2tn/CREATE_Noshiro/基板/rogger.brd

## EAGLE design 基板/rogger.brd (2018-05-12)

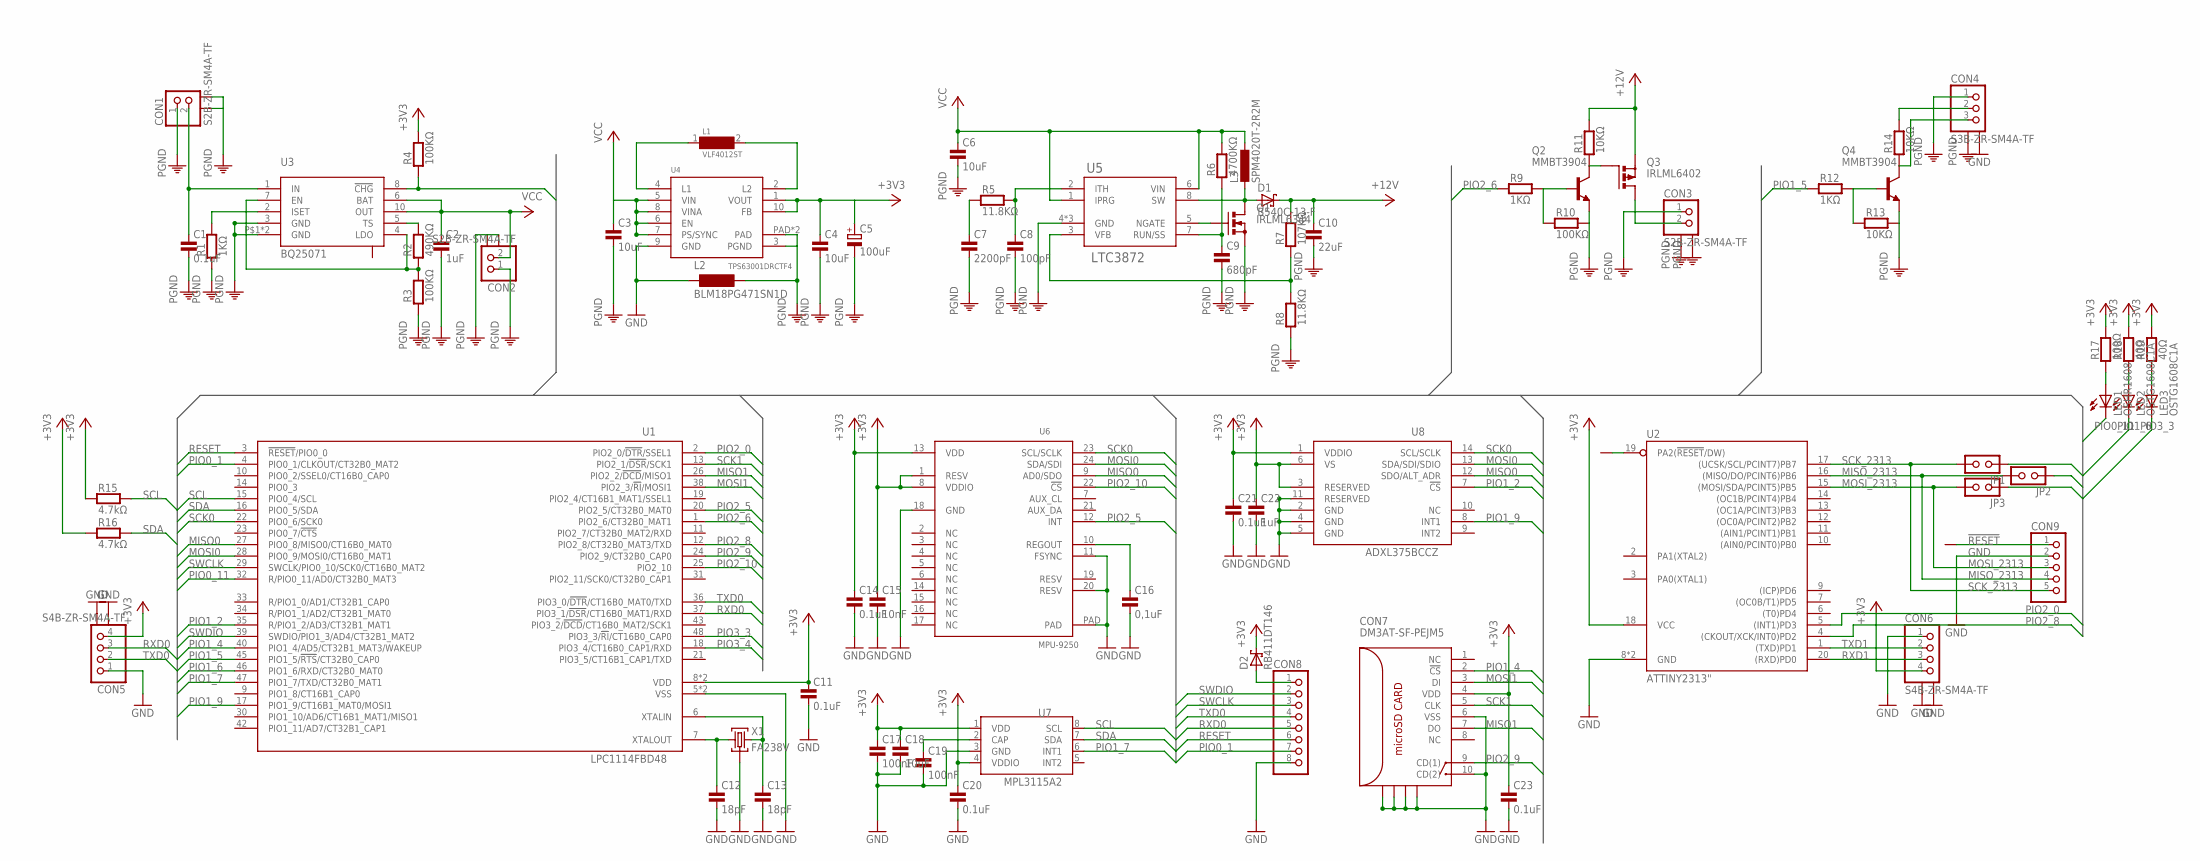
[picture p1: schematic rogger.sch]

Parts:
C1, C11, C14, C20, C21, C23: 0.1uF; 0603
C2, C22: 1uF; 0603
C3, C4, C6, C18: 10uF; 0603
C5: 100uF; 153CLV-0505
C7: 2200pF; 0603
C8: 100pF; 0603
C9: 680pF; 0603
C10: 22uF; 0805
C12, C13: 18pF; 0603
C15: 10nF; 0603
C16: 0,1uF; 0603
C17, C19: 100nF; 0603
CON1, CON2, CON3: S2B-ZR-SM4A-TF
CON4: S3B-ZR-SM4A-TF
CON5, CON6: S4B-ZR-SM4A-TF
CON7: DM3AT-SF-PEJM5
CON8: PINHEAD1X8; 1X8
CON9: PINHEAD1X5; 1X5
D1: B540C-13-F; SMC
D2: RB411DT146; SOT23
JP1, JP2, JP3: JUMP-2
L1: VLF4012ST
L2: BLM18PG471SN1D; 0603
L3: SPM4020T-2R2M
LED1: OSHR1608; CHIP-LED0603
LED2, LED3: OSTG1608C1A; CHIP-LED0603
Q1: IRLML6344; SOT23
Q2, Q4: MMBT3904; SOT23
Q3: IRLML6402; SOT23
R1, R9, R12: 1KΩ; 0603
R2: 490KΩ; 0603
R3, R4, R10: 100KΩ; 0603
R5, R8: 11.8KΩ; 0603
R6: 4700KΩ; 0603
R7: 107KΩ; 0603
R11, R13, R14: 10KΩ; 0603
R15, R16: 4.7kΩ; 0603
R17: 100Ω; 0603
R18, R19: 40Ω; 0603
U1: LPC1114FBD48; LQFP48
U2: ATTINY2313"; MLF20
U3: BQ25071; W-PWSON-N10
U4: TPS63001DRCTF4; S-PVSON-N10
U5: LTC3872; TSOT-23-8
U6: MPU-9250; 24QFN
U7: MPL3115A2
U8: ADXL375BCCZ; LGA-14
X1: FA238V; V66RA

Connections:
!RESET!: CON9.1, U2.19 (PA2(!RESET!/DW))
+3V3: C4.1, C5.+, C11.1, C14.1, C15.1, C17.1, C18.1, C20.1, C21.1, C22.1, C23.1, CON5.4, CON6.4, CON7.4 (VDD), D2.3 (C), R4.2, R15.1, R16.1, R17.2, R18.2, R19.2, U1.8 (VDD), U1.44 (VDD), U2.18 (VCC), U4.1 (VOUT), U4.10 (FB), U6.1 (RESV), U6.8 (VDDIO), U6.13 (VDD), U7.1 (VDD), U7.4 (VDDIO), U8.1 (VDDIO), U8.3 (RESERVED), U8.6 (VS)
+5V: CON4.2, R14.2
+12V: C10.1, D1.C, Q3.2 (S), R7.2, R11.2
GND: C11.2, C12.2, C13.2, C14.2, C15.2, C16.2, C17.2, C18.2, C19.2, C20.2, C21.2, C22.2, C23.2, CON4.PAD2, CON5.1, CON5.PAD1, CON5.PAD2, CON6.1, CON6.PAD1, CON6.PAD2, CON7.6 (VSS), CON7.10 (CD(2)), CON7.P$10, CON7.P$11, CON7.P$12, CON7.P$14, CON8.8, CON9.2, L2.1, U1.5 (VSS), U1.41 (VSS), U2.8 (GND), U2.P$1 (GND), U4.9 (GND), U6.11 (FSYNC), U6.18 (GND), U6.20 (RESV), U6.PAD, U7.3 (GND), U8.2 (GND), U8.4 (GND), U8.5 (GND), U8.11 (RESERVED), X1.P2GND (GND), X1.P4GND (GND)
MISO0: JP2.2, U1.27 (PIO0_8/MISO0/CT16B0_MAT0), U6.9 (AD0/SDO), U8.12 (SDO/ALT_ADR)
MISO1: CON7.7 (DO), U1.26 (PIO2_2/!DCD!/MISO1)
MISO_2313: CON9.4, JP2.1, U2.16 ((MISO/DO/PCINT6)PB6)
MOSI0: JP3.2, U1.28 (PIO0_9/MOSI0/CT16B0_MAT1), U6.24 (SDA/SDI), U8.13 (SDA/SDI/SDIO)
MOSI1: CON7.3 (DI), U1.38 (PIO2_3/!RI!/MOSI1)
MOSI_2313: CON9.3, JP3.1, U2.15 ((MOSI/SDA/PCINT5)PB5)
unnamed: C12.1, U1.7 (XTALOUT), X1.P1X1 (X1)
unnamed: C13.1, U1.6 (XTALIN), X1.P3X2 (X2)
unnamed: CON8.1, D2.1 (A)
unnamed: L1.1, U4.4 (L1)
unnamed: L1.2, U4.2 (L2)
unnamed: C19.1, U7.2 (CAP)
unnamed: Q1.1 (G), U5.5 (NGATE)
unnamed: D1.A, L3.P$2 (2), Q1.3 (D), U5.8 (SW)
unnamed: C16.1, U6.10 (REGOUT)
unnamed: C9.1, R6.1, U5.7 (RUN/SS)
unnamed: R1.2, U3.2 (ISET)
unnamed: R7.1, R8.2, U5.3 (VFB)
unnamed: R2.2, U3.5 (TS)
unnamed: R2.1, R3.2, U3.4 (LDO), U3.7 (EN)
unnamed: C8.1, R5.2, U5.2 (ITH)
unnamed: CON3.2, Q3.3 (D)
unnamed: C7.1, R5.1
unnamed: Q2.3 (C), Q3.1 (G), R11.1
unnamed: CON4.3, Q4.3 (C), R14.1
unnamed: Q2.1 (B), R9.2, R10.1
unnamed: Q4.1 (B), R12.2, R13.1
unnamed: LED1.A, R17.1
unnamed: C1.1, CON1.2, U3.1 (IN)
unnamed: LED2.A, R18.1
unnamed: LED3.A, R19.1
PAD: U3.9 (PAD)
PE: C1.2, C2.2, C3.2, C4.2, C5.-, C6.2, C7.2, C8.2, C9.2, C10.2, CON1.1, CON1.PAD1, CON1.PAD2, CON2.1, CON2.PAD1, CON2.PAD2, CON3.1, CON3.PAD1, CON3.PAD2, CON4.1, CON4.PAD1, L2.2, Q1.2 (S), Q2.2 (E), Q4.2 (E), R1.1, R3.1, R8.1, R10.2, R13.2, U3.3 (GND), U3.P$1 (GND), U3.PAD (GND), U4.3 (PGND), U4.PAD, U4.PAD@1 (PAD), U5.4 (GND), U5.P$1 (GND), U5.P$2 (GND)
PIO0_1: CON8.7, U1.4 (PIO0_1/CLKOUT/CT32B0_MAT2)
PIO0_11: LED1.C, U1.32 (R/PIO0_11/AD0/CT32B0_MAT3)
PIO1_2: U1.35 (R/PIO1_2/AD3/CT32B1_MAT1), U8.7 (!CS!)
PIO1_4: CON7.2 (!CS!), U1.40 (PIO1_4/AD5/CT32B1_MAT3/WAKEUP)
PIO1_5: R12.1, U1.45 (PIO1_5/!RTS!/CT32B0_CAP0)
PIO1_6: LED2.C, U1.46 (PIO1_6/RXD/CT32B0_MAT0)
PIO1_7: U1.47 (PIO1_7/TXD/CT32B0_MAT1), U7.6 (INT1)
PIO1_9: U1.17 (PIO1_9/CT16B1_MAT0/MOSI1), U8.8 (INT1)
PIO2_0: U1.2 (PIO2_0/!DTR!/SSEL1), U2.5 ((INT1)PD3)
PIO2_5: U1.20 (PIO2_5/CT32B0_MAT0), U6.12 (INT)
PIO2_6: R9.1, U1.1 (PIO2_6/CT32B0_MAT1)
PIO2_8: U1.12 (PIO2_8/CT32B0_MAT3/TXD), U2.4 ((CKOUT/XCK/INT0)PD2)
PIO2_9: CON7.9 (CD(1)), U1.24 (PIO2_9/CT32B0_CAP0)
PIO2_10: U1.25 (PIO2_10), U6.22 (!CS!)
PIO3_3: LED3.C, U1.48 (PIO3_3/!RI!/CT16B0_CAP0)
PIO3_4: R4.1, U1.18 (PIO3_4/CT16B0_CAP1/RXD), U3.8 (!CHG!)
RESET: CON8.6, U1.3 (!RESET!/PIO0_0)
RXD0: CON5.3, CON8.5, U1.37 (PIO3_1/!DSR!/CT16B0_MAT1/RXD)
RXD1: CON6.3, U2.20 ((RXD)PD0)
SCK0: JP1.2, U1.22 (PIO0_6/SCK0), U6.23 (SCL/SCLK), U8.14 (SCL/SCLK)
SCK1: CON7.5 (CLK), U1.13 (PIO2_1/!DSR!/SCK1)
SCK_2313: CON9.5, JP1.1, U2.17 ((UCSK/SCL/PCINT7)PB7)
SCL: R15.2, U1.15 (PIO0_4/SCL), U7.8 (SCL)
SDA: R16.2, U1.16 (PIO0_5/SDA), U7.7 (SDA)
SWCLK: CON8.3, U1.29 (SWCLK/PIO0_10/SCK0/CT16B0_MAT2)
SWDIO: CON8.2, U1.39 (SWDIO/PIO1_3/AD4/CT32B1_MAT2)
TXD0: CON5.2, CON8.4, U1.36 (PIO3_0/!DTR!/CT16B0_MAT0/TXD)
TXD1: CON6.2, U2.1 ((TXD)PD1)
VCC: C2.1, C3.1, C6.1, CON2.2, L3.P$1 (1), R6.2, U3.6 (BAT), U3.10 (OUT), U4.5 (VIN), U4.6 (EN), U4.7 (PS/SYNC), U4.8 (VINA), U5.1 (IPRG), U5.6 (VIN)

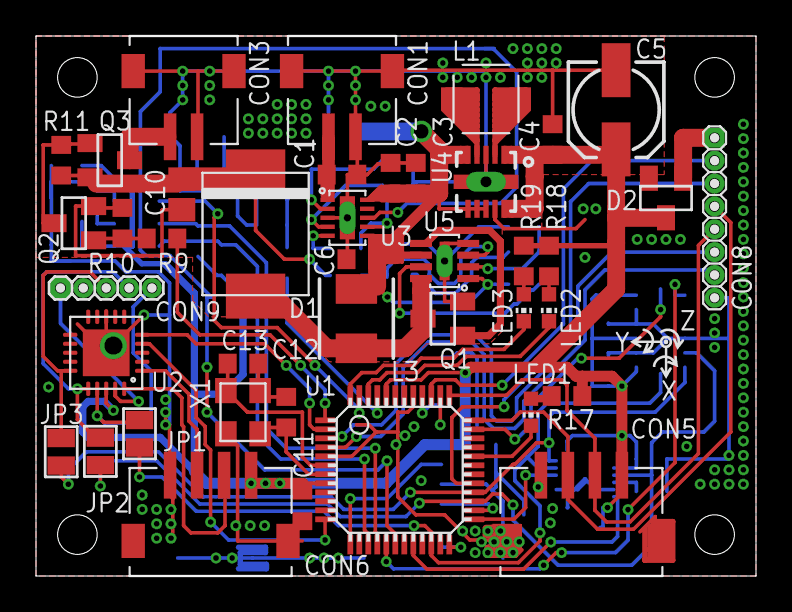
[picture p2: board rogger.brd from above]

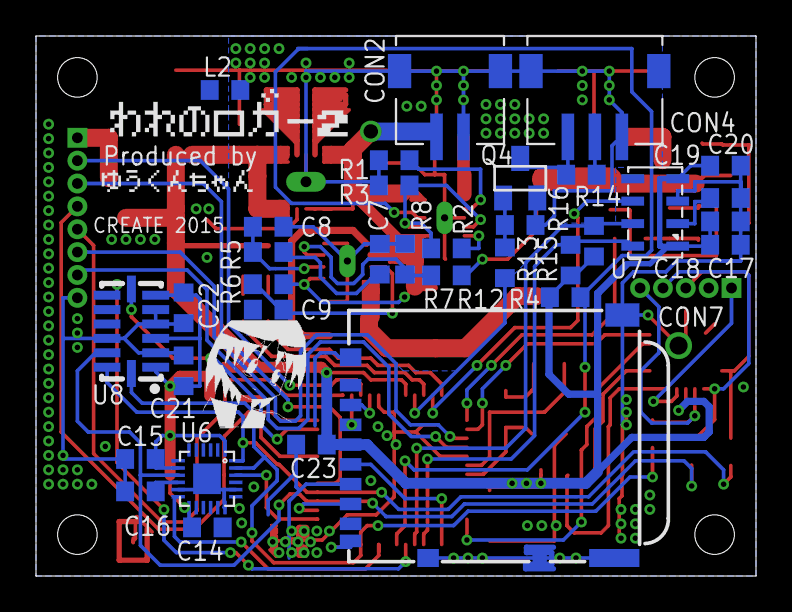
[picture p3: board rogger.brd from below]

Board: 2 copper layers, 40.0 x 30.0 mm, 76 parts (34 on the bottom side), 66 nets.

Other parts of the board:
U$1: DIRECTION
